jmherzog-de/Design-Competition-MR-HHN-WS18-19/images/Throwout-Diagram.png

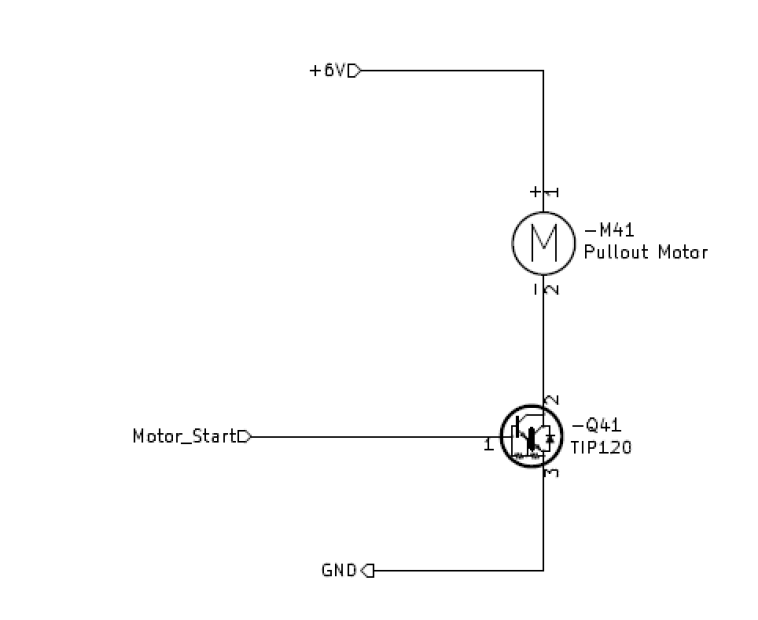
images/Throwout-Diagram.png
