jmherzog-de/Design-Competition-MR-HHN-WS18-19/Elektronik/CircuitDiagram_Rev3.pdf

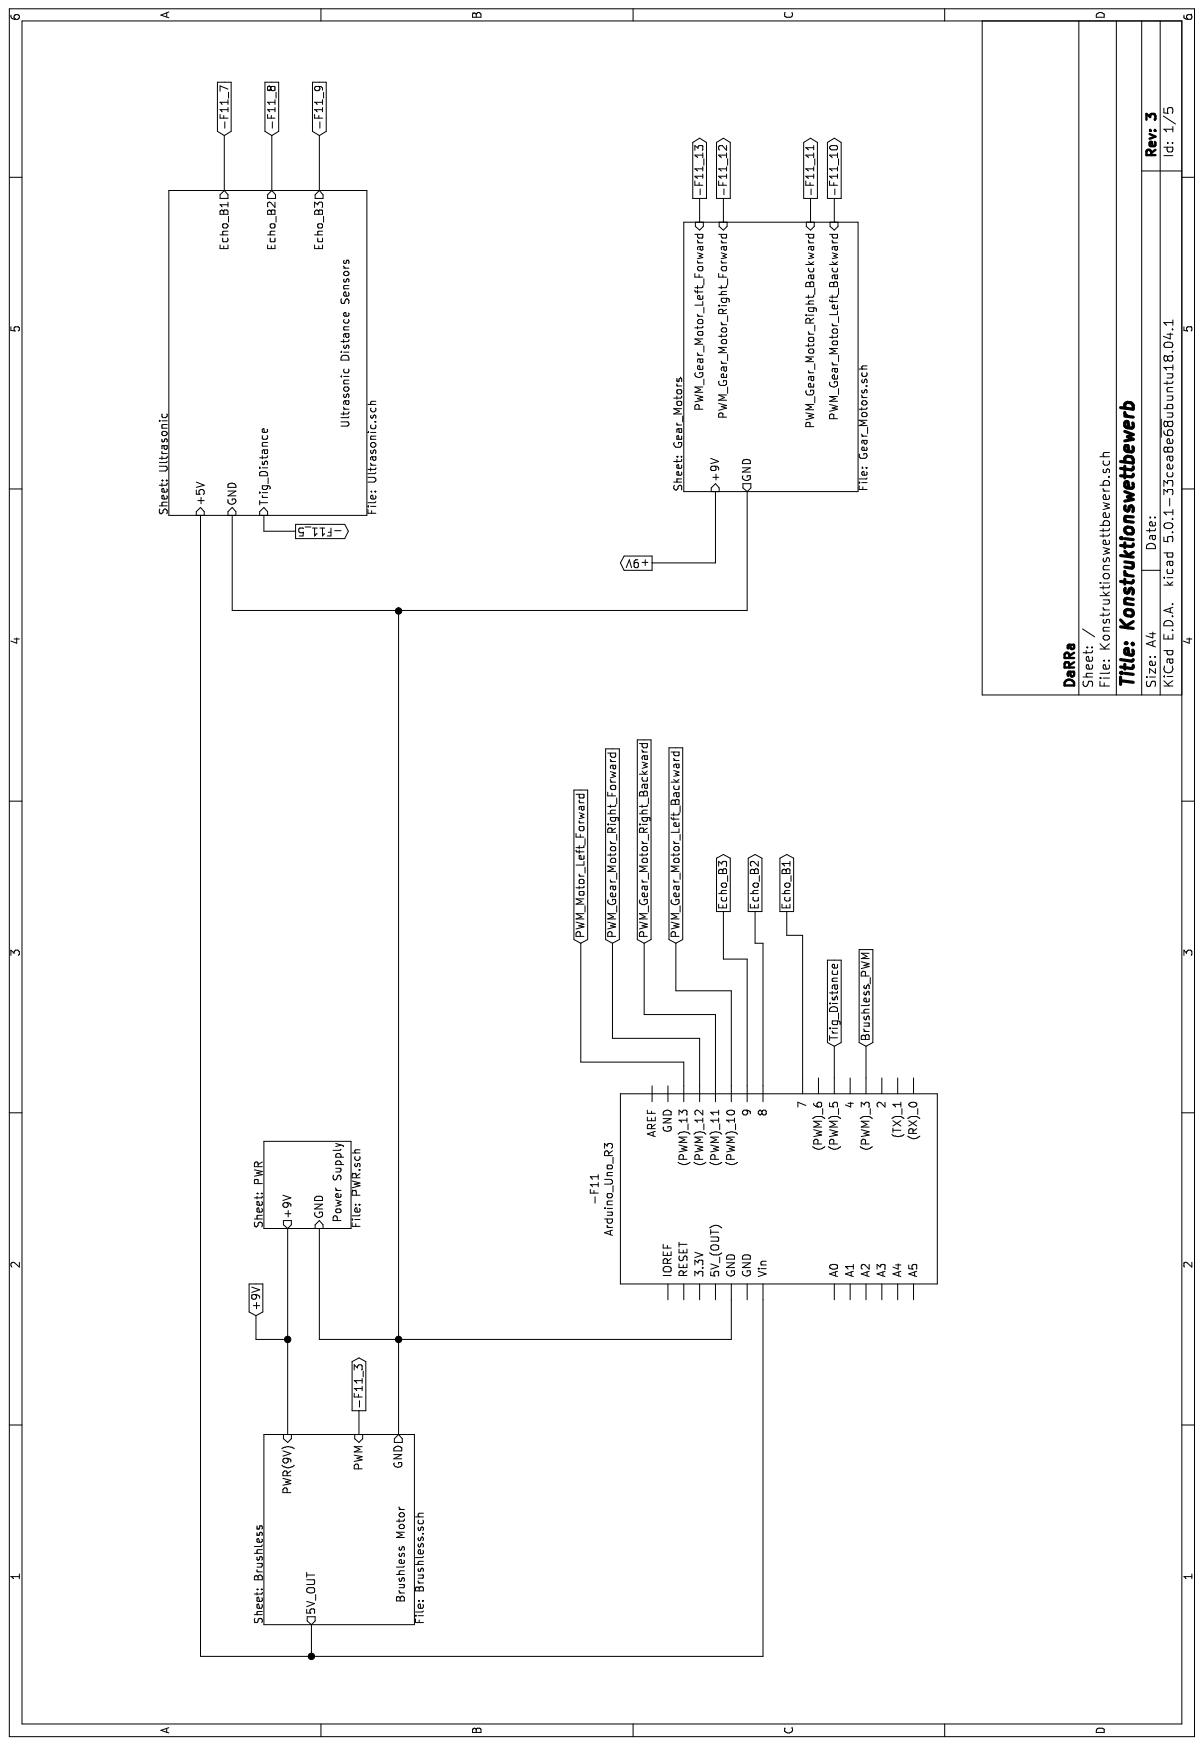
[picture p22: page 1]

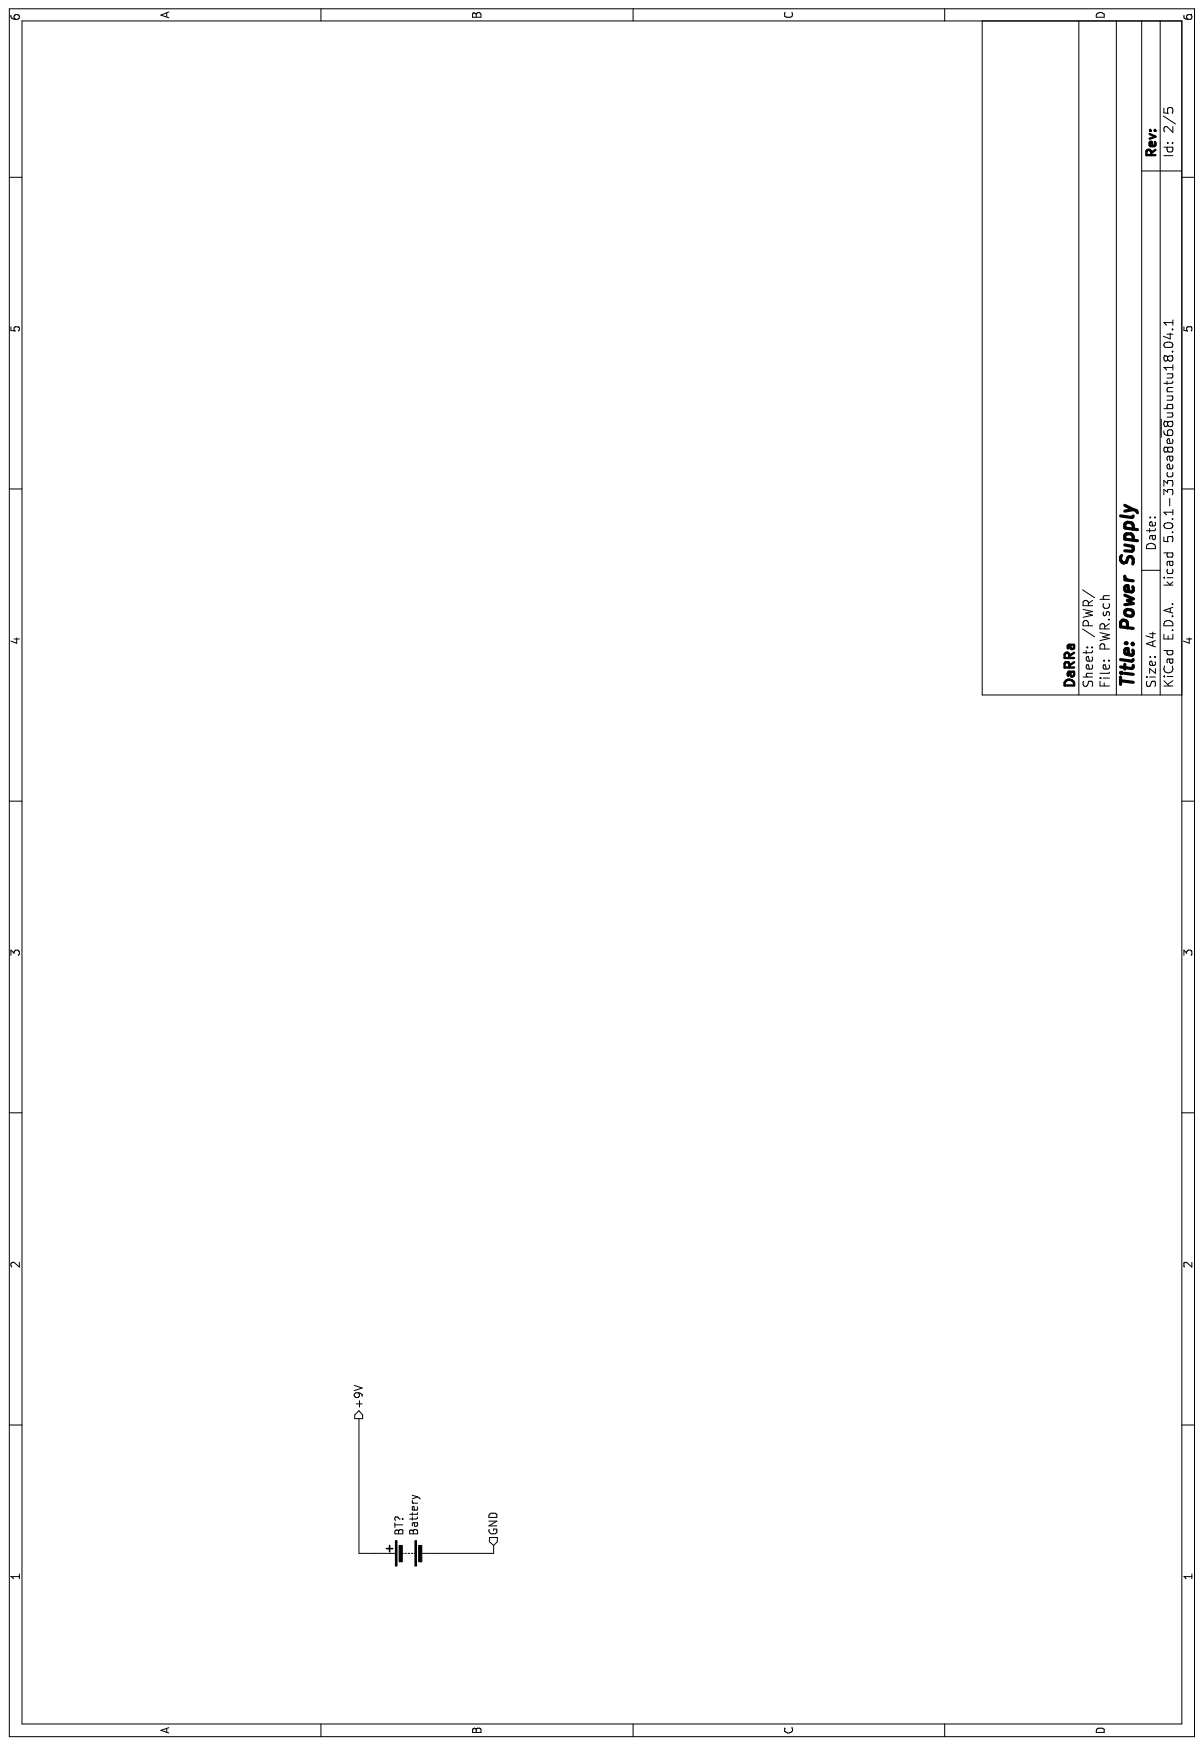
[picture p23: page 2]

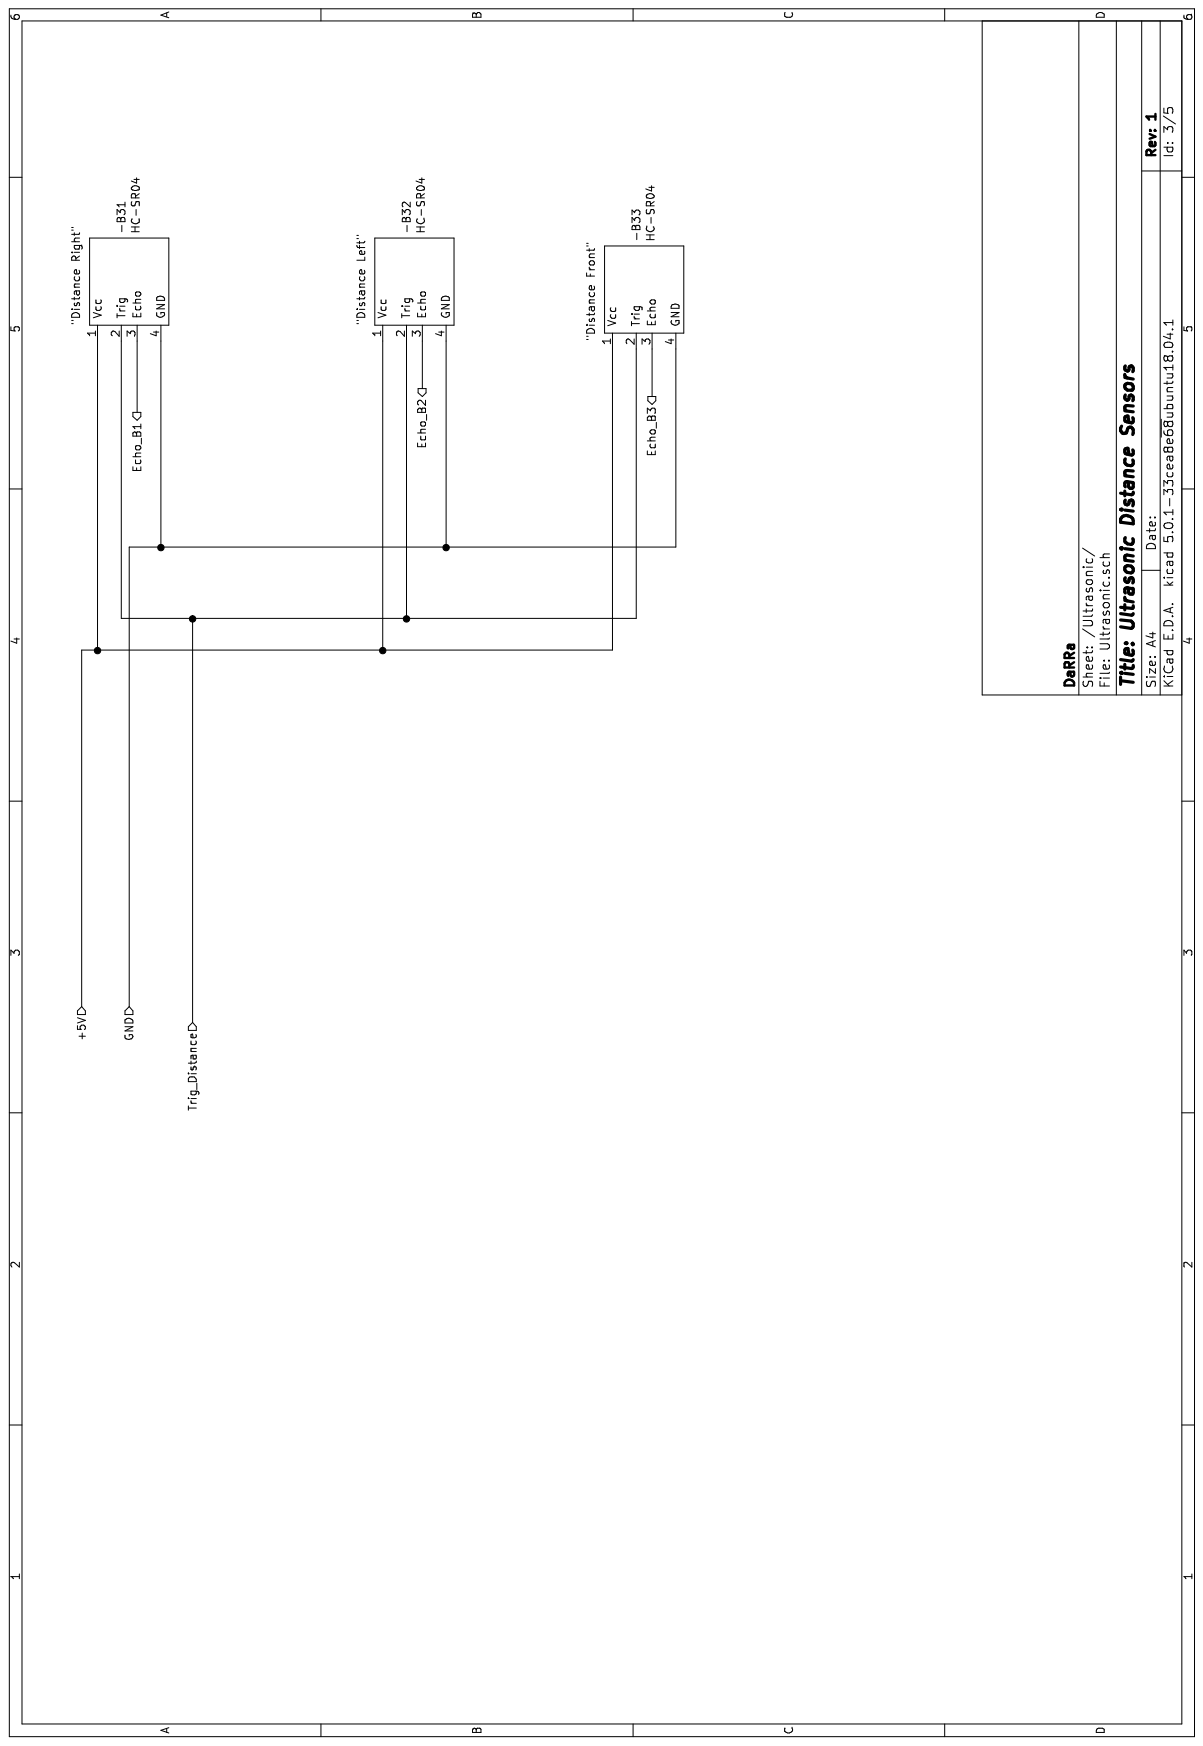
[picture p24: page 3]

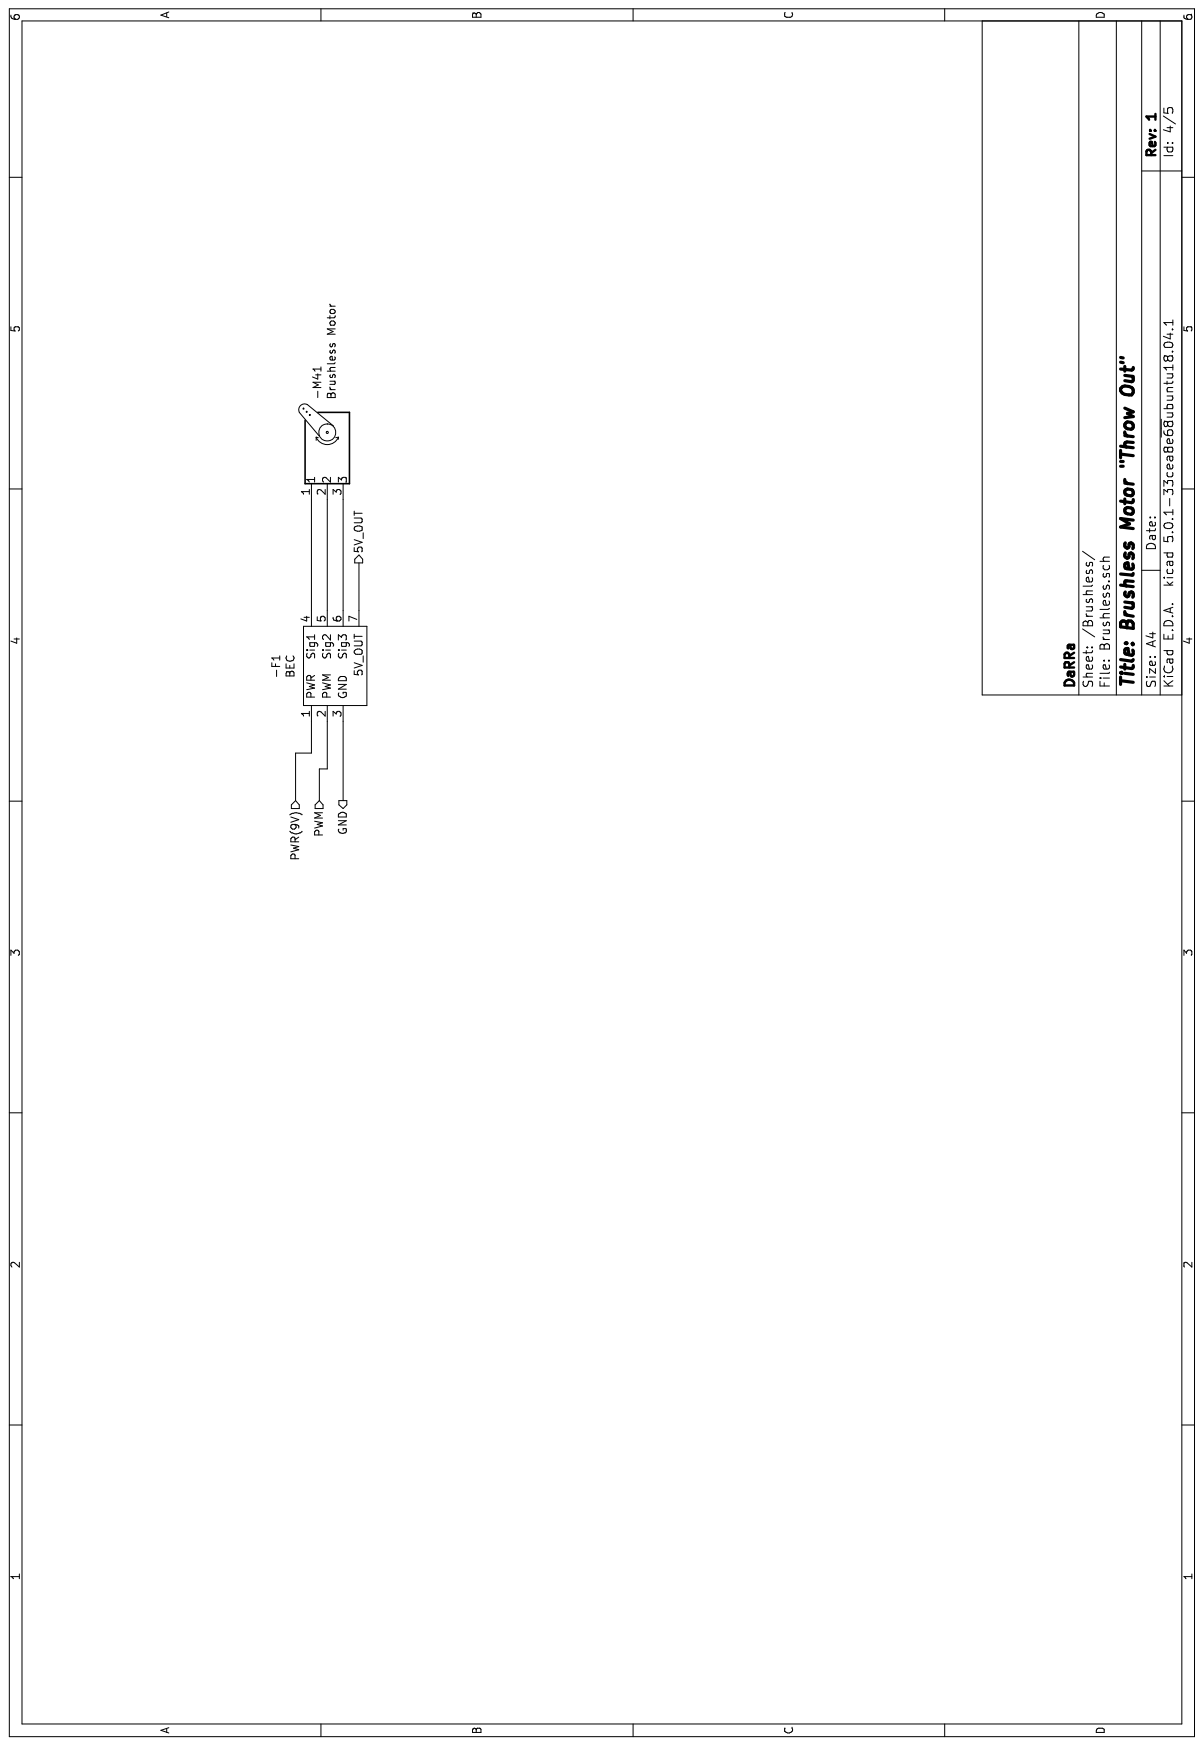
[picture p25: page 4]

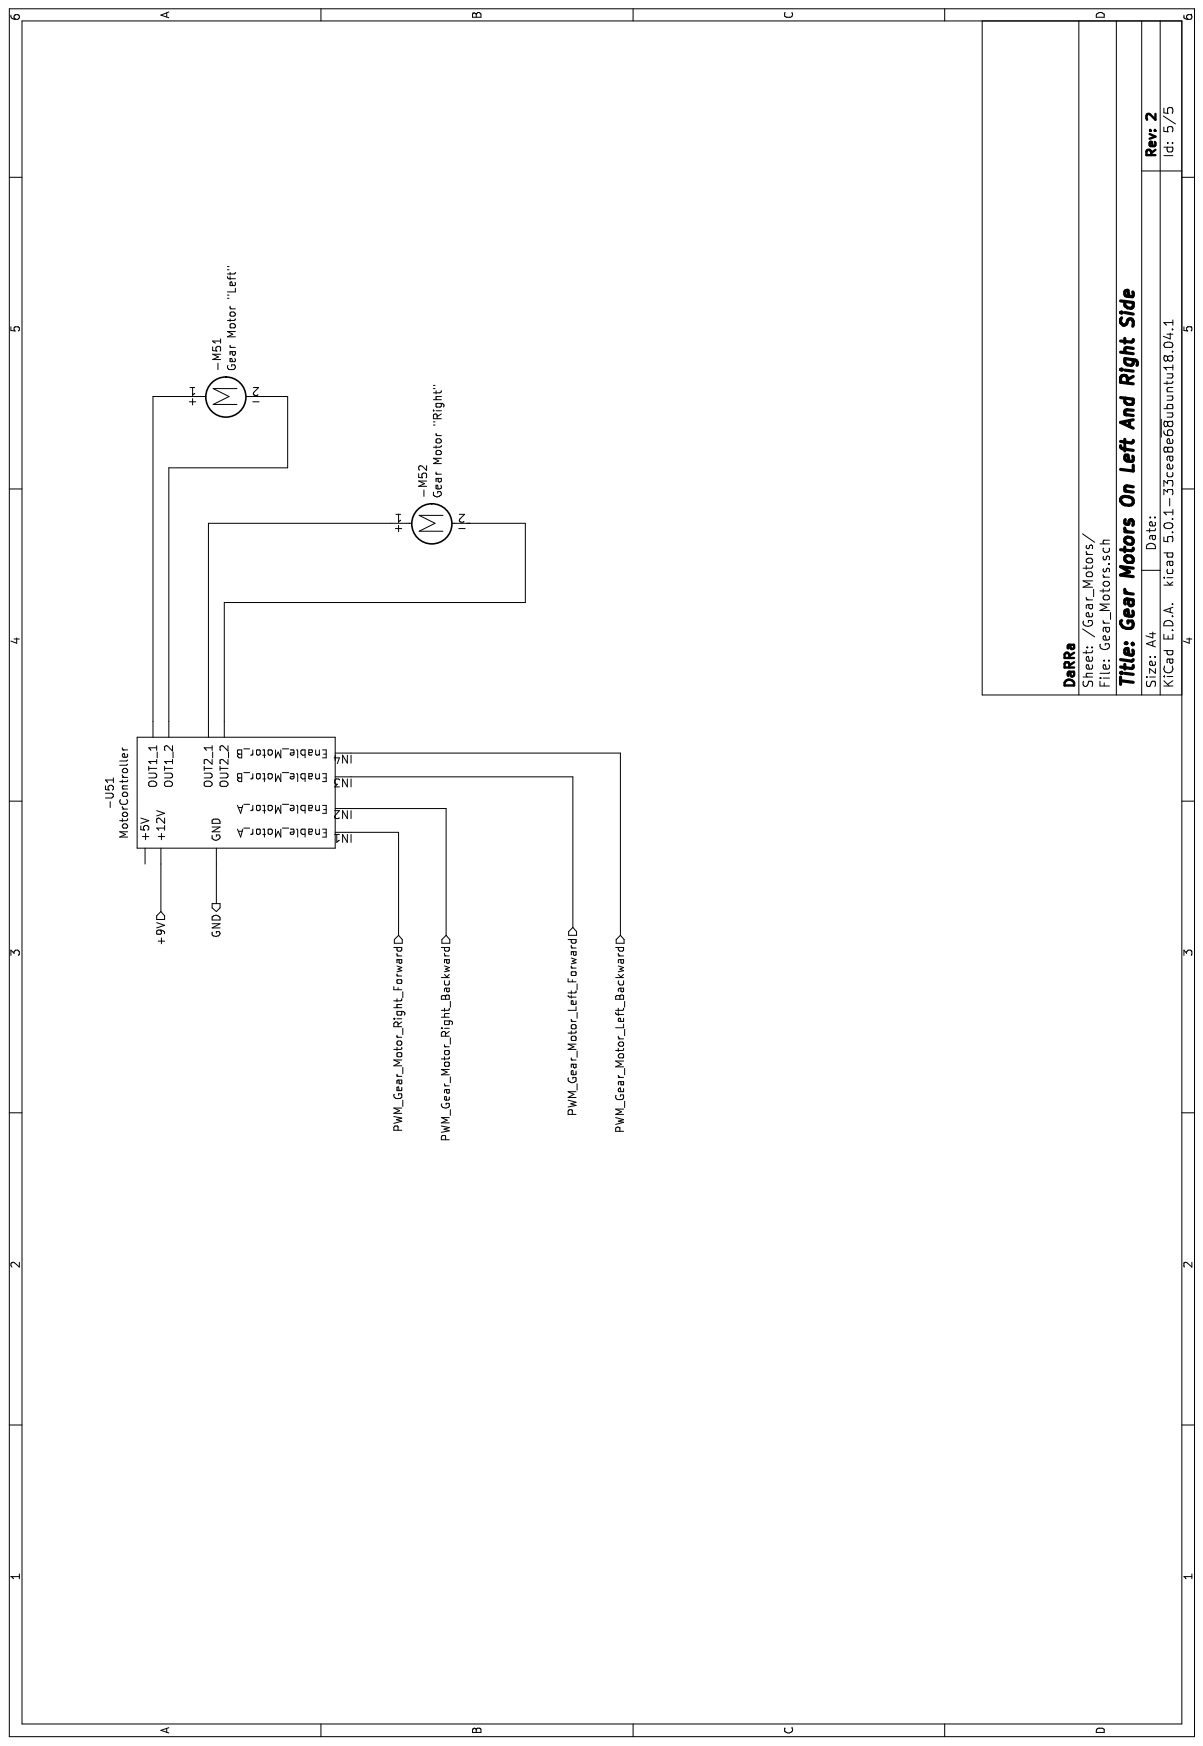
[picture p26: page 5]
