jmherzog-de/Design-Competition-MR-HHN-WS18-19/Elektronik/Konstruktionswettbewerb/Brushless.sch

## KiCad design Elektronik/Konstruktionswettbewerb/Brushless.sch (2020-09-12)

Schematic: Brushless.sch

Parts:
-M41: Motor_DC
-Q42: FDMS86202ET120; TDSON-8-1
