jmherzog-de/Design-Competition-MR-HHN-WS18-19/Elektronik/Konstruktionswettbewerb/DC-Motor.sch

## KiCad design Elektronik/Konstruktionswettbewerb/DC-Motor.sch (2020-09-12)

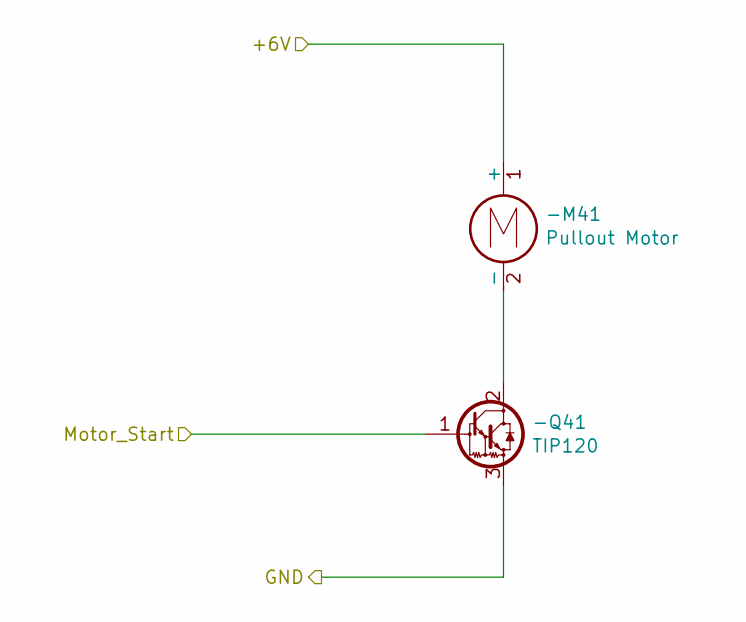
[picture p27: schematic DC-Motor.sch]

Parts:
-M41: Pullout Motor
-Q41: TIP120; TO-220-3_Vertical

Connections:
+6V: -M41.1 (+)
GND: -Q41.3 (E)
Motor_Start: -Q41.1 (B)
unnamed: -M41.2 (-), -Q41.2 (C)
