jmherzog-de/Design-Competition-MR-HHN-WS18-19/Elektronik/Konstruktionswettbewerb/Gear-Motor.sch

## KiCad design Elektronik/Konstruktionswettbewerb/Gear-Motor.sch (2020-09-12)

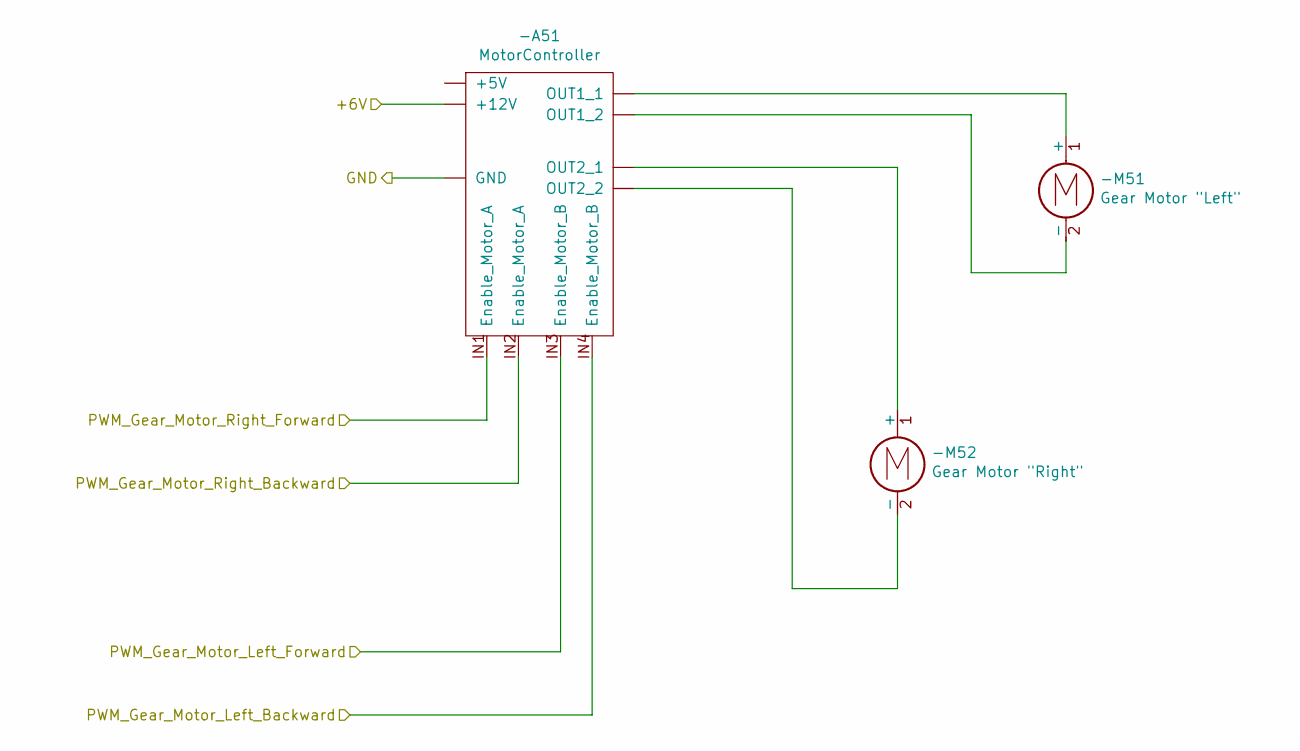
[picture p28: schematic Gear-Motor.sch]

Parts:
-A51: MotorController
-M51: Gear Motor \"Left\"
-M52: Gear Motor \"Right\"

Connections:
+6V: -A51.~ (+12V)
GND: -A51.~ (+12V)
unnamed: -A51.~ (+12V), -M51.1 (+), -M51.2 (-), -M52.1 (+), -M52.2 (-)
PWM_Gear_Motor_Left_Backward: -A51.IN4 (Enable_Motor_B)
PWM_Gear_Motor_Left_Forward: -A51.IN3 (Enable_Motor_B)
PWM_Gear_Motor_Right_Backward: -A51.IN2 (Enable_Motor_A)
PWM_Gear_Motor_Right_Forward: -A51.IN1 (Enable_Motor_A)
