jmherzog-de/Design-Competition-MR-HHN-WS18-19/Elektronik/Konstruktionswettbewerb/Konstruktionswettbewerb.sch

## KiCad design Elektronik/Konstruktionswettbewerb/Konstruktionswettbewerb.sch (2020-09-12)

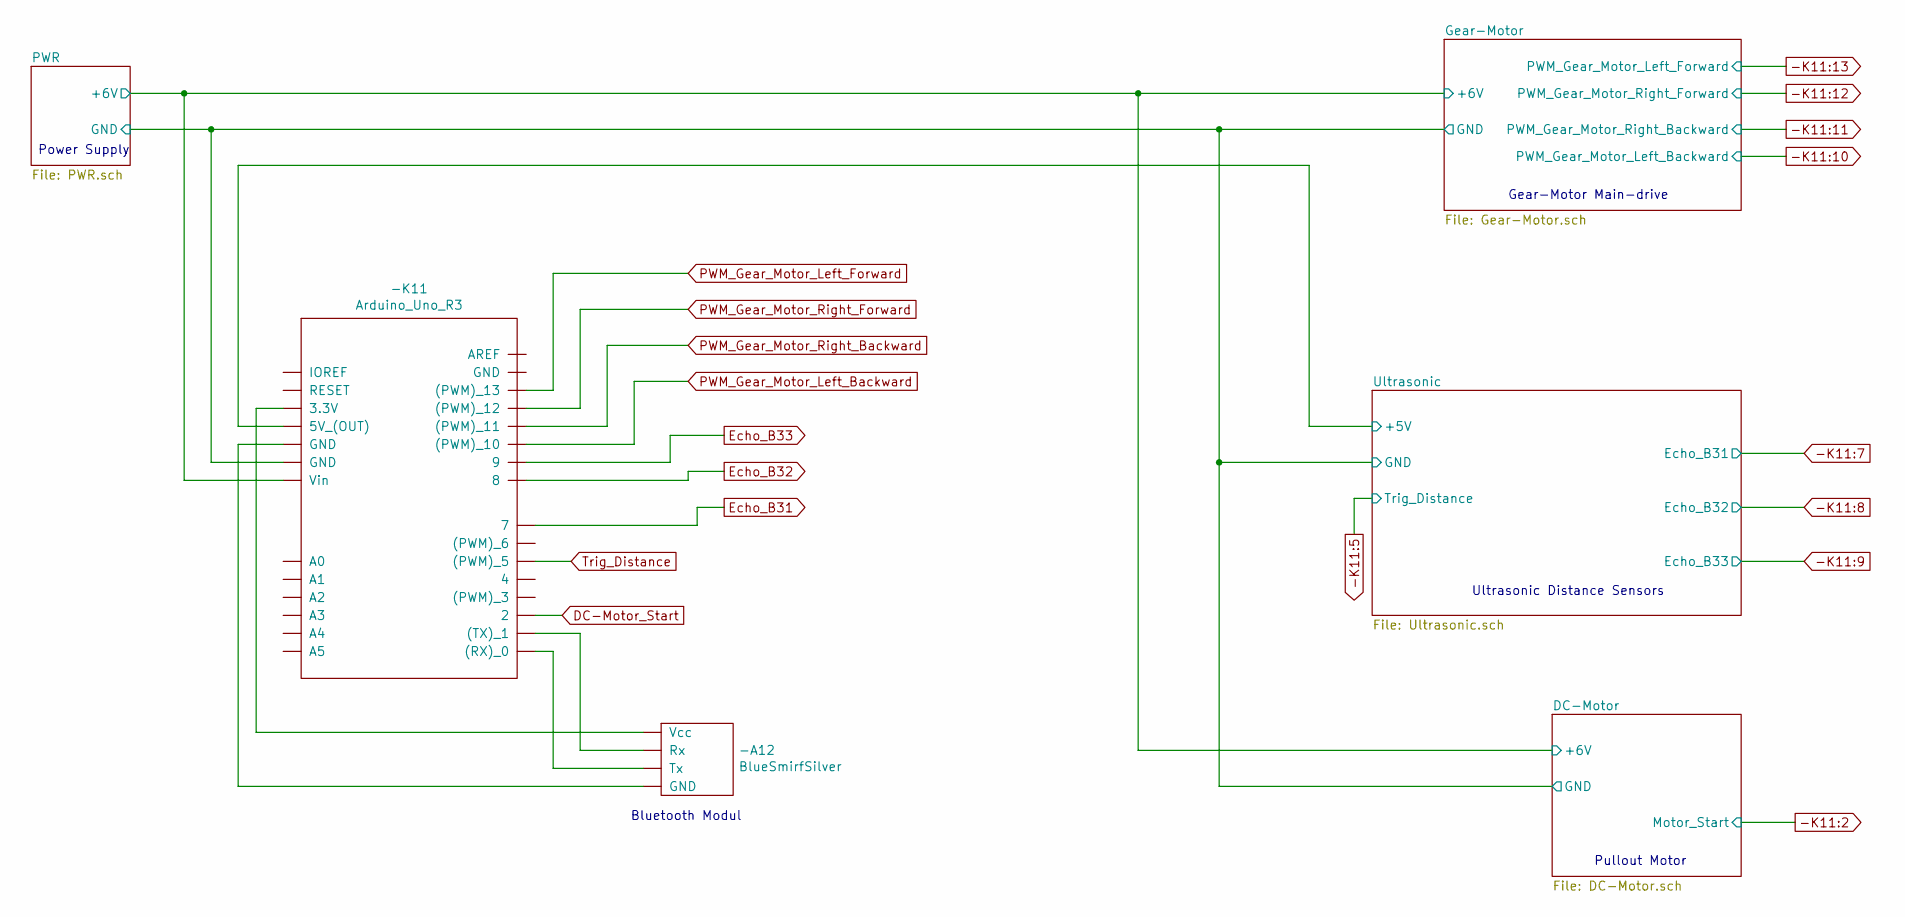
[picture p29: schematic Konstruktionswettbewerb.sch]

Parts:
-A12: BlueSmirfSilver
-K11: Arduino_Uno_R3

Connections:
+5V: -K11.~
+6V: -K11.~
DC-Motor_Start: -K11.~
Echo_B31: -K11.~
Echo_B32: -K11.~
Echo_B33: -K11.~
GND: -K11.~
unnamed: -A12.~, -K11.~
PWM_Gear_Motor_Left_Backward: -K11.~
PWM_Gear_Motor_Left_Forward: -K11.~
PWM_Gear_Motor_Right_Backward: -K11.~
PWM_Gear_Motor_Right_Forward: -K11.~
Trig_Distance: -K11.~

Notes on the sheet:
Ultrasonic Distance Sensors
Power Supply
Gear-Motor Main-drive
Pullout Motor
Bluetooth Modul
