jmherzog-de/Design-Competition-MR-HHN-WS18-19/Elektronik/Konstruktionswettbewerb/PWR.sch

## KiCad design Elektronik/Konstruktionswettbewerb/PWR.sch (2020-09-12)

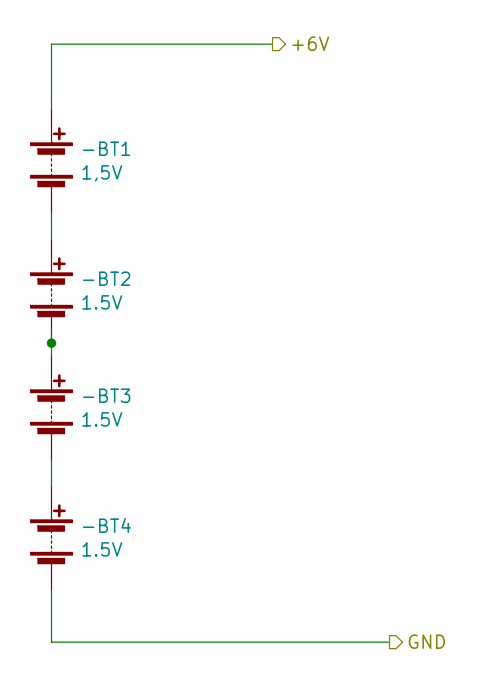
[picture p30: schematic PWR.sch]

Parts:
-BT1: 1,5V
-BT2, -BT3, -BT4: 1.5V

Connections:
+6V: -BT1.1 (+)
GND: -BT4.2 (-)
unnamed: -BT1.2 (-), -BT2.1 (+)
unnamed: -BT2.2 (-), -BT3.1 (+)
unnamed: -BT3.2 (-), -BT4.1 (+)
