jmherzog-de/Design-Competition-MR-HHN-WS18-19/Elektronik/Konstruktionswettbewerb/Ultrasonic.sch

## KiCad design Elektronik/Konstruktionswettbewerb/Ultrasonic.sch (2020-09-12)

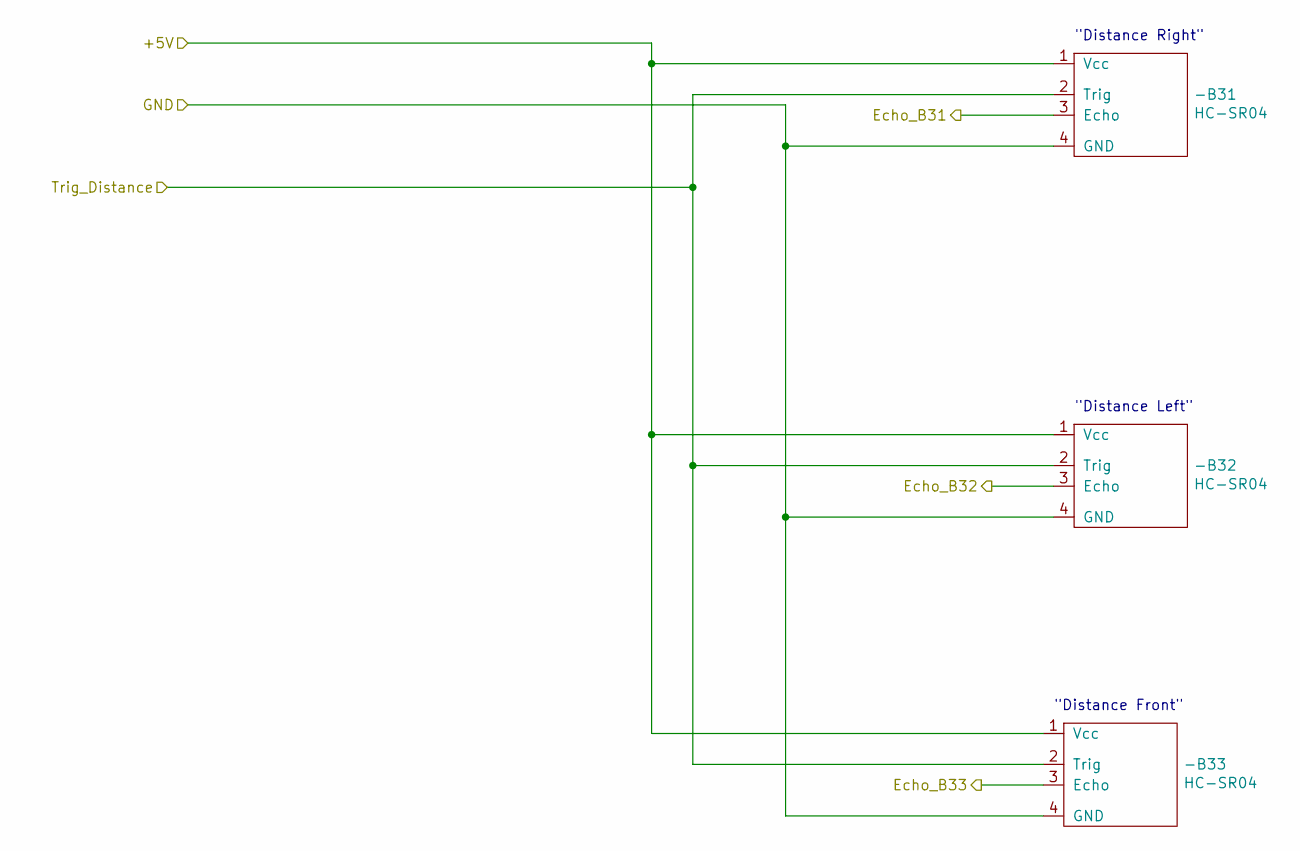
[picture p31: schematic Ultrasonic.sch]

Parts:
-B31, -B32, -B33: HC-SR04

Connections:
+5V: -B31.1 (Vcc), -B32.1 (Vcc), -B33.1 (Vcc)
Echo_B31: -B31.3 (Echo)
Echo_B32: -B32.3 (Echo)
Echo_B33: -B33.3 (Echo)
GND: -B31.4 (GND), -B32.4 (GND), -B33.4 (GND)
Trig_Distance: -B31.2 (Trig), -B32.2 (Trig), -B33.2 (Trig)

Notes on the sheet:
"Distance Right"
"Distance Left"
"Distance Front"
